shibbs/Light_node/Documentation/Hardware_configuration_notes.rtf

If you want to control an external LED Strip :

By default the LED strip must be powered from USB power. To change it so that the LED strip can be controlled from battery power you need to :
Cut the 5V trace that runs to the LED strip (show picture)
Solder the Vbatt line to the LED strip’s 5V pin (show picture)

If you do not intend to ever use Battery power but still want to use the LEDs on board:
Do not populate U10 and the surrounding electronics
Solder short JP11
May have trouble controlling the LEDs still, not sure really because of voltage issues on board

If you don’t want to use the accelerometer
Do not populate U20 and surrounding parts
