shibbs/Light_node/pcb_design/board info.rtf

gerber info :

cutout/dxf : OTL
Top copper : GTL
bottom copper GBL
top paste GTP
bottom silk GBO
top soldermask GTS
bottom soldermask GBS
drill info DRI
drill location txt
