shibbs/Light_node/Documentation/Purchase_list.rtf

validation issues that require clarification
IST 71047 71046 71045

1 x pack of 3-pin JST conectors - https://www.amazon.com/HKBAYI-50Pair-50sets-Connector-WS2812B/dp/B00NBSH4CA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.

9 x 5m LED Strips https://www.amazon.com/dp/B0722XX2RK/ref=sspa_dk_detail_0?th=1

1 x 1m high density LED Strip - https://www.amazon.com/gp/product/B01CDTEJR0/ref=ox_sc_act_title_2?smid=A35UAT07QG3EC6&psc=1

1 x Spirit hood - https://www.amazon.com/gp/product/B075VS5ZLP/ref=oh_aui_detailpage_o01_s00?ie=UTF8&psc=1

Send reminder/prep e-mail
get code working and sorted
make basic functions
