shibbs/Light_node/light_node_BOM.xls

Sheet: BOM_11_26
Digi-Key Part Number | Manufacturer | Manufacturer Part Number | Description | Customer Reference |  | Quantity 1 | Price | 7.4712 | Quantity 2 | Price | Quantity 3 | Price | Stock Status | Mfg Std Lead Time | Comments | RoHS Status | Lead Free Status | REACH Status
497-10613-1-ND | STMICROELECTRONICS (VA) | LIS3DHTR | ACCEL 2-16G I2C/SPI 16LGA | U20 | Accel | 35 | 1.37 | 1.37 | 0 | 0.00000 | 0 | 0.00000 | IN STOCK | 16 Weeks | Alternate Packaging Exists | RoHS Compliant | Lead free | Not Available
BAW56LT1GOSCT-ND | ON SEMICONDUCTOR (VA) | BAW56LT1G | DIODE ARRAY GP 70V 200MA SOT23-3 | U50 | Strip Diodes | 35 | 0.098 | 0.098 | 0 | 0.00000 | 0 | 0.00000 | IN STOCK | 12 Weeks | Alternate Packaging Exists | RoHS Compliant | Lead free | Unaffected Jul-2017
ATMEGA328P-MURCT-ND | MICROCHIP TECHNOLOGY (VA) | ATMEGA328P-MUR | IC MCU 8BIT 32KB FLASH 32VQFN | U30 | MCU | 35 | 2.0056 | 2.0056 | 0 | 0.00000 | 0 | 0.00000 | IN STOCK | 16 Weeks | Alternate Packaging Exists | RoHS Compliant | Lead free | Unaffected Jan-2017
MCP73831T-2ACI/OTCT-ND | MICROCHIP TECHNOLOGY (VA) | MCP73831T-2ACI/OT | IC CONTROLLR LI-ION 4.2V SOT23-5 | U10 | Batt- IC | 35 | 0.4936 | 0.4936 | 0 | 0.00000 | 0 | 0.00000 | IN STOCK | 6 Weeks | Alternate Packaging Exists | RoHS Compliant | Lead free | Unaffected Jan-2017
576-2980-1-ND | MICROCHIP TECHNOLOGY (VA) | MIC5225-3.3YM5-TR | IC REG LINEAR 3.3V 150MA SOT23-5 | U40 | MCU Reg | 35 | 0.336 | 0.336 | 0 | 0.00000 | 0 | 0.00000 | IN STOCK | 6 Weeks | Alternate Packaging Exists | RoHS Compliant | Lead free | Unaffected Jan-2017
455-1802-1-ND | JST SALES AMERICA INC (VA) | SM02B-SRSS-TB(LF)(SN) | CONN HEADER SH 2POS SIDE 1MM TIN | JP11 | Batt-Con | 35 | 0.415 | 0.415 | 0 | 0.00000 | 0 | 0.00000 | IN STOCK | 14 Weeks | Alternate Packaging Exists | RoHS Compliant | Lead free | Not Available
455-1626-ND | JST SALES AMERICA INC | S3B-EH(LF)(SN) | CONN HEADER EH SIDE 3POS 2.5MM | JP3 | Strip- Conn | 35 | 0.187 | 0.187 | 0 | 0.00000 | 0 | 0.00000 | IN STOCK | 14 Weeks |  | RoHS Compliant | Lead free | Not Available
3306P-104-ND | BOURNS INC | 3306P-1-104 | TRIMMER 100K OHM 0.2W PC PIN | R7 | POT | 35 | 0.36 | 0.36 | 0 | 0.00000 | 0 | 0.00000 | AVAIL 0/BAL 18 WKS ARO | 18 Weeks |  | RoHS Compliant | Lead free | Unaffected Jan-2017
609-4618-1-ND | AMPHENOL FCI (VA) | 10118194-0001LF | CONN USB MICRO B RECPT SMT R/A | USB_PORT | MCU USB Conn | 35 | 0.3744 | 0.3744 | 0 | 0.00000 | 0 | 0.00000 | IN STOCK | 12 Weeks | Alternate Packaging Exists | RoHS Compliant | Lead free | Not Available
401-1999-1-ND | C&K (VA) | JS102011SAQN | SWITCH SLIDE SPDT 300MA 6V | U$8 – SWITCH | Switch | 35 | 0.5016 | 0.5016 | 0 | 0.00000 | 0 | 0.00000 | IN STOCK | 10 Weeks | Alternate Packaging Exists | RoHS Compliant | Lead free | Unaffected Jan-2017
1253-1675-1-ND |  |  | 16Mhz Crystal | Y30 | MCU Xtal | 35 | 0.33 | 0.33
 | Neopixel |  |  |  | LEDs | 70 | 0.5 | 1
 | Lion Battery |  |  |  | BATtery | 35 |  | 0
 |  |  |  | Basic stuff |  |  |  | 4.046
 |  |  |  | Accel |  |  |  | 1.37
 |  |  |  | SWITCH |  |  |  | 0.5016
 |  |  |  | LEDs |  |  |  | 1
 |  |  |  | LED Strip |  |  |  | 0.285
 |  |  |  | Battery |  |  |  | 0.9086
 |  |  |  | Potentiometer |  |  |  | 0.36
Stencil | 19.66 |  |  |  |  |  |  | 8.4712
PCBs x 60
Solder Paste

Sheet: partlist
Partlist
Exported | from Light_node.sch at | 11/29/17 4:14 PM
EAGLE Ver | sion 7.5.0 Copyright (c | ) 1988-2015 CadSoft
Assembly | variant:
Part | Value | Device | Package Library Sheet
C10 | 10uF | CAP_CERAMIC0805-NOOUTLINE | 0805-NO microbuilder 1
C11 | 10uF | CAP_CERAMIC0805-NOOUTLINE | 0805-NO microbuilder 1
C20 | 10uF | CAP_CERAMIC0805-NOOUTLINE | 0805-NO microbuilder 1
C30 | 0.1uF | CAP_CERAMIC_0805MP | _0805MP microbuilder 1
C31 | 0.1uF | CAP_CERAMIC0805-NOOUTLINE | 0805-NO microbuilder 1
C40 | 10uF | CAP_CERAMIC0805-NOOUTLINE | 0805-NO microbuilder 1
C41 | 10uF | CAP_CERAMIC0805-NOOUTLINE | 0805-NO microbuilder 1
R1 | 68 (0603) | RESISTOR_0603_NOOUT | 0603-NO microbuilder 1
R10 | 470 | RESISTOR0805_NOOUTLINE | 0805-NO microbuilder 1
R11 | 10K | RESISTOR0805_NOOUTLINE | 0805-NO microbuilder 1
R2 | 68 (0603) | RESISTOR_0603_NOOUT | 0603-NO microbuilder 1
R3 | 1.5K (0603) | RESISTOR_0603_NOOUT | 0603-NO microbuilder 1
R20 | 10K | RESISTOR0805_NOOUTLINE | 0805-NO microbuilder 1
R21 | 10K | RESISTOR0805_NOOUTLINE | 0805-NO microbuilder 1
R30 | 10K (0603) | RESISTOR0805_NOOUTLINE | 0805-NO microbuilder 1
R50 | 10K | RESISTOR_0603_NOOUT | 0603-NO microbuilder 1
R40 | 470 (0603) | RESISTOR_0603_NOOUT | 0603-NO microbuilder 1
R5 | 470 (0603) | RESISTOR_0603_NOOUT | 0603-NO microbuilder 1
R9 | 470 (0603) | RESISTOR_0603_NOOUT | 0603-NO microbuilder 1
RGB1 | WS2812B5050 | WS2812B5050 | WS2812B microbuilder 1
RGB2 | WS2812B5050 | WS2812B5050 | WS2812B microbuilder 1
U$8 | SPDT_NO_GNDSMT | SPDT_NO_GNDSMT | JS102011SAQN 0_Shibbs1 1
U10 | MCP73831T-2ACI/OT | MCP73831/2 | SOT23-5 microbuilder 1
U20 | LIS3DHTR | ACCEL_LIS3DHTR | LGA16_3X3MM microbuilder 1
U30 | ATmega328P | MEGA8-MI | MLF32-TH microbuilder 1
U40 | MIC5225-3.3v | LP298XS | SOT23-5L adafruit 1
U50 | COMMON_ANODE_DIODE | COMMON_ANODE_DIODE | SOT23 0_AlpineLabs 1
Y30 | 12MHz | RESONATORSMD | RESONATOR-SMD SparkFun 1
B1 | GREEN | LED0805_NOOUTLINE | CHIPLED_0805_NOOUTLINE microbuilder 1 | All LEDs are same in BOM
PWR_LED | green | LED0805_NOOUTLINE | CHIPLED_0805_NOOUTLINE microbuilder 1 | All LEDs are same in BOM
CH_LED | GREEN | LED0805_NOOUTLINE | CHIPLED_0805_NOOUTLINE microbuilder 1 | All LEDs are same in BOM
D40 | SCHOTTKY | DIODE_SOD-123FL | SOD-123FL adafruit 1
JP1 | USB_MICROB_PLUG_CUSTOM | USB_MICROB_PLUG_CUSTOM | USB-MICROB 0_AlpineLabs 1
JP3 | JSTPH | JST_2PIN | JSTPH2 microbuilder 1
JP5 | M03 | M03 | M03_25MM 0_Shibbs1 1
POT |  | POT | 3306P_POT 0_Shibbs1 1
