shibbs/Light_node/Placement_Guideline2 copy.jpg

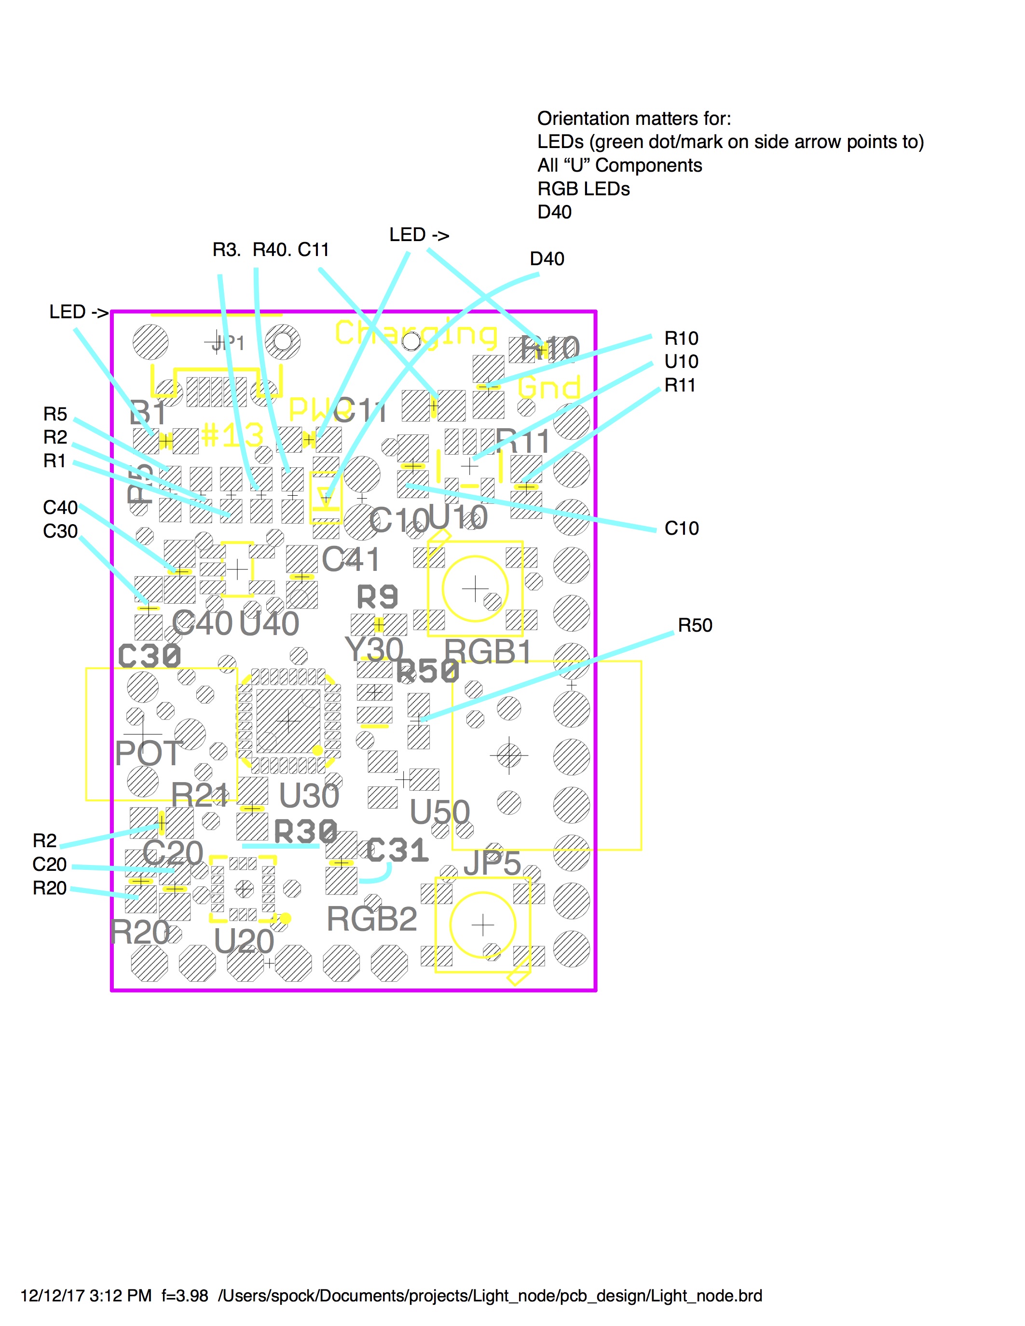
Placement_Guideline2 copy.jpg
