shibbs/Light_node/Placement_Guideline2.pdf

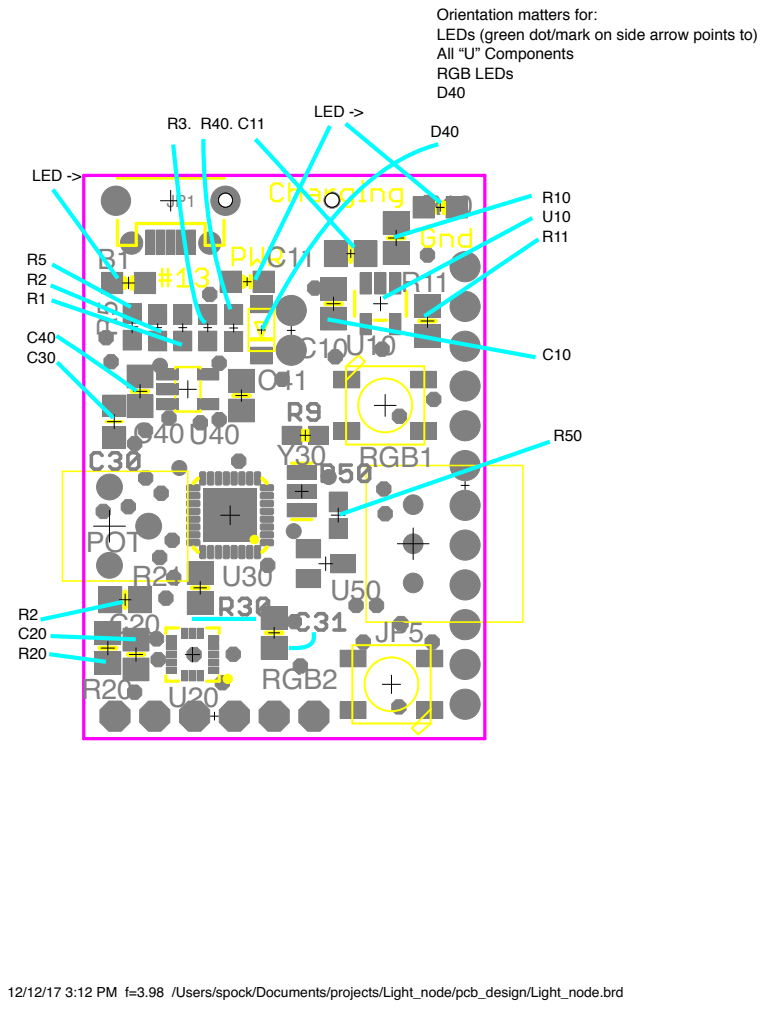
[picture p2: page 1]

Orientation matters for:
LEDs (green dot/mark on side arrow points to)
All “U” Components
RGB LEDs

12/12/17 3:12 PM f=3.98 /Users/spock/Documents/projects/Light_node/pcb_design/Light_node.brd
