shibbs/Light_node/pcb_design/Light_node.brd

## EAGLE design pcb_design/Light_node.brd (2017-12-17)

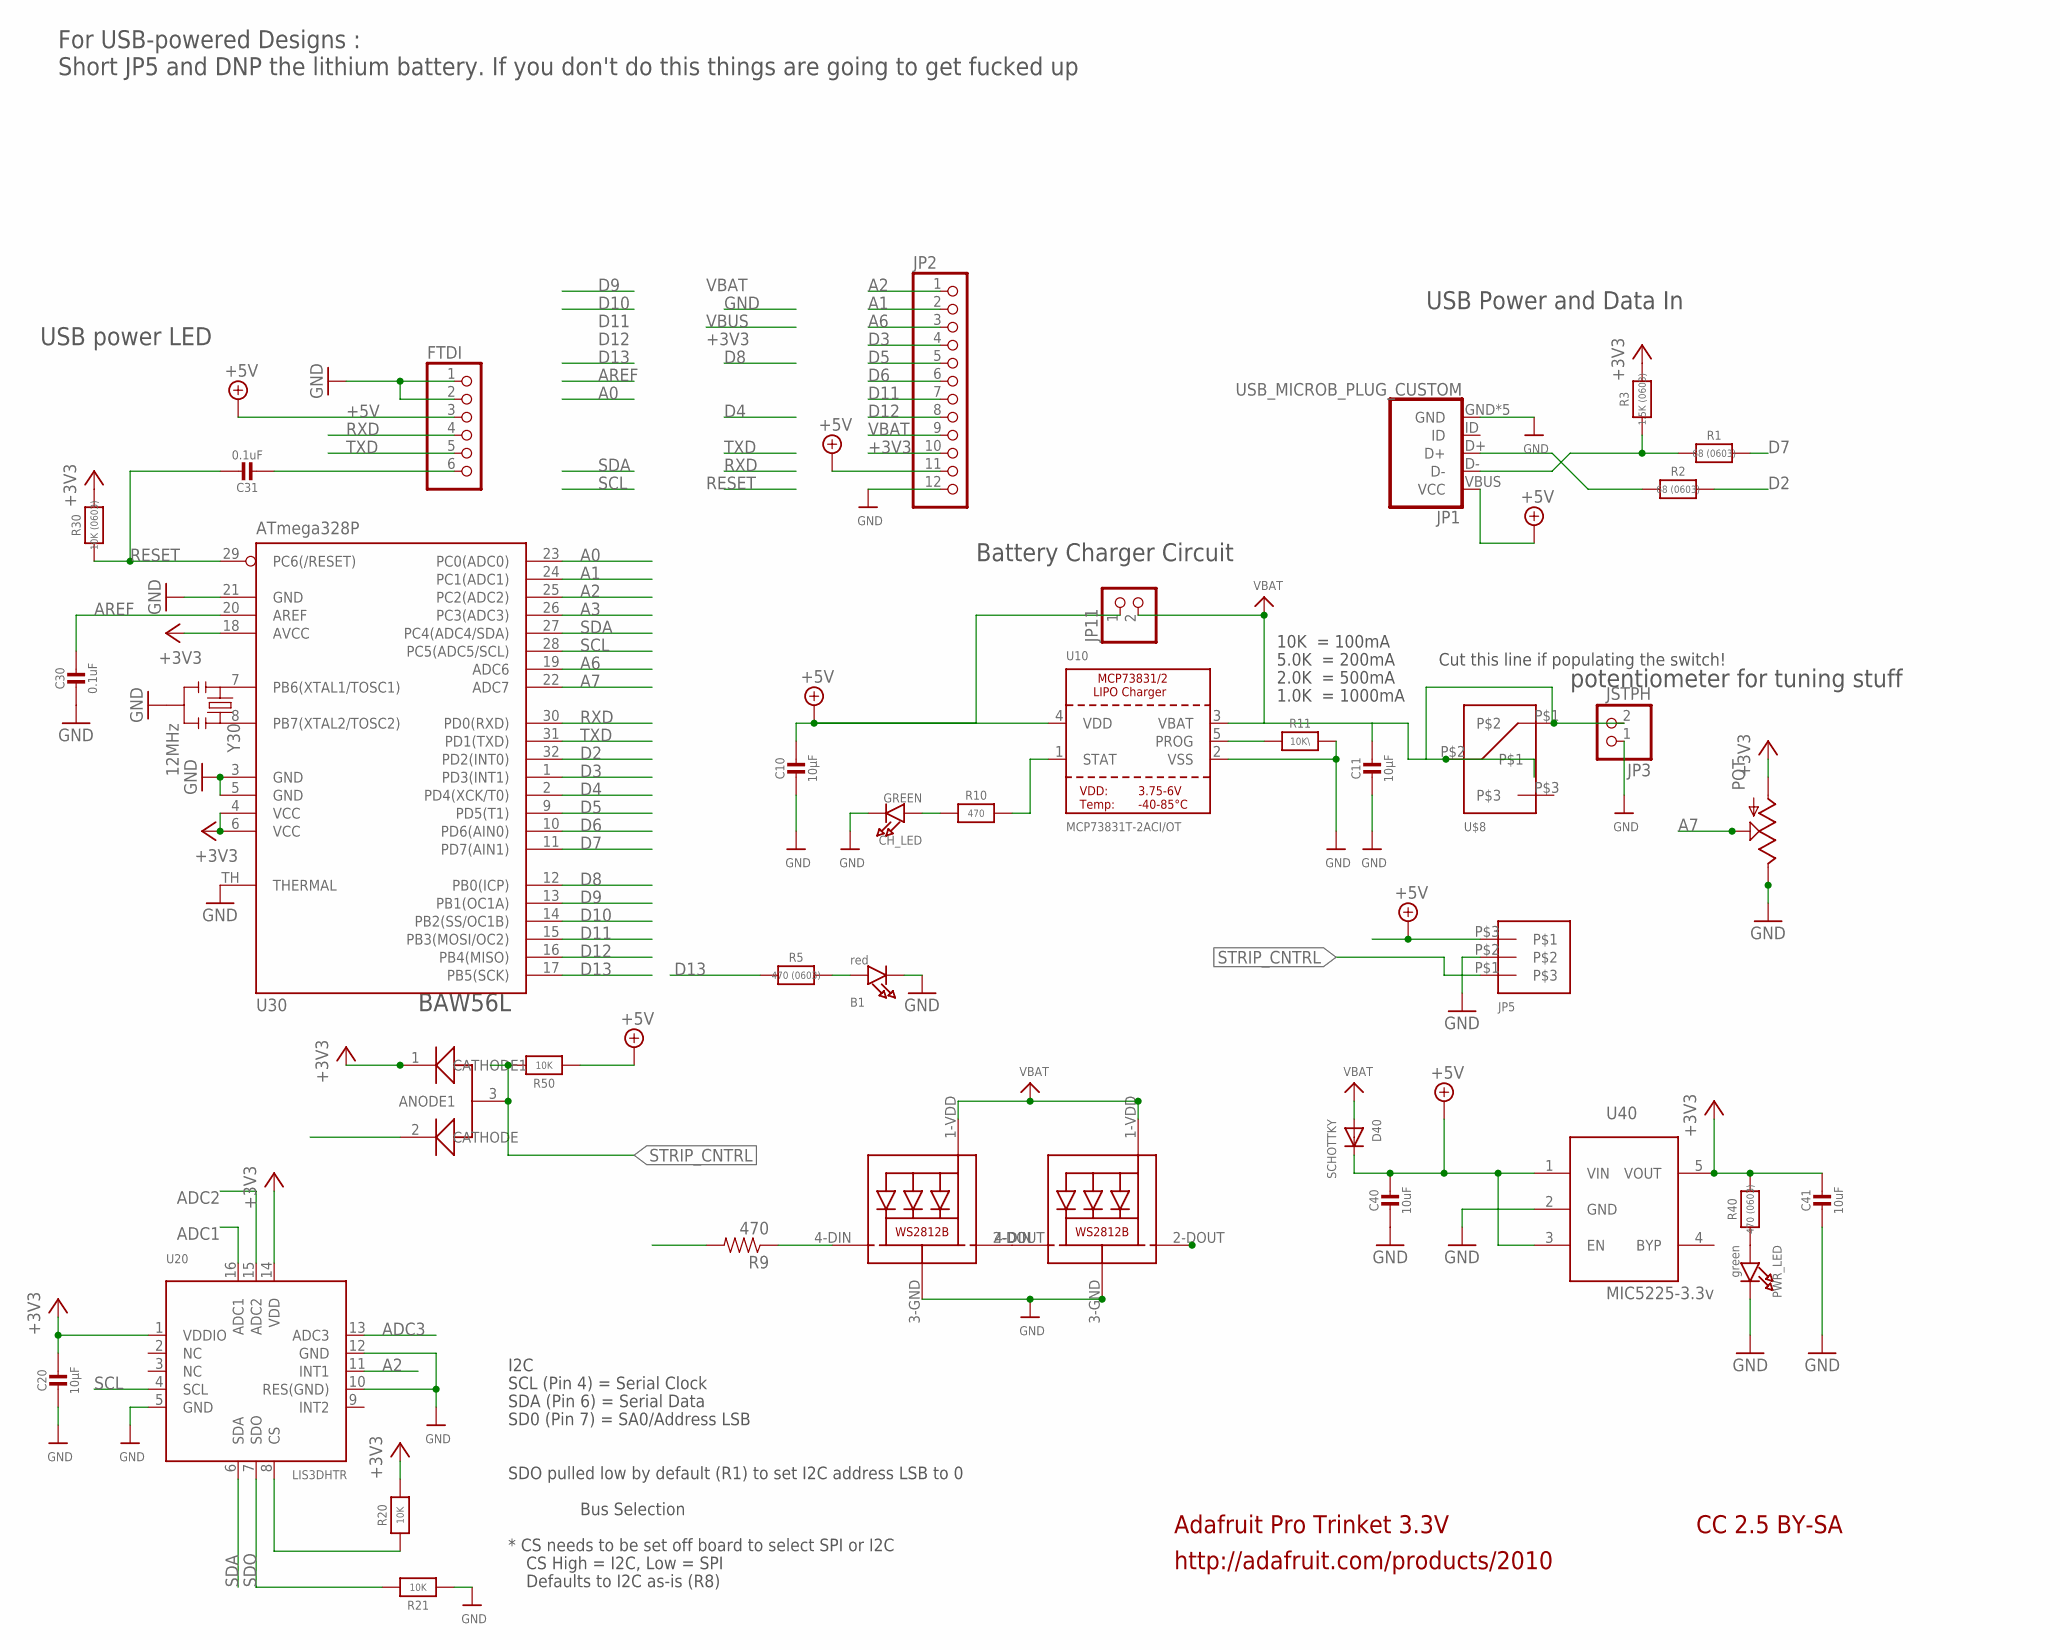
[picture p3: schematic Light_node.sch]

Parts:
B1: red; CHIPLED_0805_NOOUTLINE
C10, C11, C20: 10µF; 0805-NO
C30: 0.1uF; _0805MP
C31: 0.1uF; 0805-NO
C40, C41: 10uF; 0805-NO
CH_LED: GREEN; CHIPLED_0805_NOOUTLINE
D40: SCHOTTKY; SOD-123FL
FTDI: PINHD-1X6CB; 1X06-CLEANBIG
JP1: USB_MICROB_PLUG_CUSTOM; USB-MICROB
JP2: PINHD-1X12-CB; 1X12-CB
JP3: JSTPH; JSTPH2
JP5: M03; M03_25MM
JP11: HEADER-1X2ROUND; 1X02_ROUND
POT: POT; 3306P_POT
PWR_LED: green; CHIPLED_0805_NOOUTLINE
R1, R2: 68 (0603); 0603-NO
R3: 1.5K (0603); 0603-NO
R5, R40: 470 (0603); 0603-NO
R9: 470; 0603-RES
R10: 470; 0805-NO
R11: 10K\; 0805-NO
R20, R21: 10K; 0805-NO
R30: 10K (0603); 0805-NO
R50: 10K; 0603-NO
RGB1, RGB2: WS2812B5050; WS2812B
U10: MCP73831T-2ACI/OT; SOT23-5
U20: LIS3DHTR; LGA16_3X3MM
U30: ATmega328P; MLF32-TH
U40: MIC5225-3.3v; SOT23-5L
U50: COMMON_ANODE_DIODE; SOT23
U$8: SPDT_NO_GNDSMT; JS102011SAQN
Y30: 12MHz; RESONATOR-SMD

Connections:
+3V3: C20.1, C41.1, JP2.10, POT.P$1 (A), R3.2, R20.2, R30.2, R40.2, U20.1 (VDDIO), U20.14 (VDD), U30.4 (VCC), U30.6 (VCC), U30.18 (AVCC), U40.5 (VOUT), U50.1 (CATHODE1)
+5V: C10.1, C40.1, D40.C, FTDI.3, JP1.VBUS (VCC), JP2.11, JP5.P$3, JP11.1, R50.1, U10.4 (VDD), U40.1 (VIN), U40.3 (EN)
A0: U30.23 (PC0(ADC0))
A1: JP2.2, U30.24 (PC1(ADC1))
A2: JP2.1, U20.11 (INT1), U30.25 (PC2(ADC2))
A3: U30.26 (PC3(ADC3))
A6: JP2.3, U30.19 (ADC6)
A7: POT.P$3 (S), U30.22 (ADC7)
ADC1: U20.16 (ADC1)
ADC2: U20.15 (ADC2)
ADC3: U20.13 (ADC3)
AREF: C30.1, U30.20 (AREF)
CS: R20.1, U20.8 (CS)
D2: R2.2, U30.32 (PD2(INT0))
D3: JP2.4, U30.1 (PD3(INT1))
D4: U30.2 (PD4(XCK/T0)), U50.2 (CATHODE)
D5: JP2.5, U30.9 (PD5(T1))
D6: JP2.6, U30.10 (PD6(AIN0))
D7: R1.2, U30.11 (PD7(AIN1))
D8: U30.12 (PB0(ICP))
D9: U30.13 (PB1(OC1A))
D10: R9.2, U30.14 (PB2(SS/OC1B))
D11: JP2.7, U30.15 (PB3(MOSI/OC2))
D12: JP2.8, U30.16 (PB4(MISO))
D13: R5.2, U30.17 (PB5(SCK))
D+: JP1.D+, R2.1
D-: JP1.D-, R1.1, R3.1
DTR/RTS: C31.2, FTDI.6
GND: B1.C, C10.2, C11.2, C20.2, C30.2, C40.2, C41.2, CH_LED.C, FTDI.1, FTDI.2, JP1.GND, JP1.P$1 (GND), JP1.P$2 (GND), JP1.P$3 (GND), JP1.P$4 (GND), JP2.12, JP3.1, JP5.P$2, POT.P$2 (E), PWR_LED.C, R11.2, R21.1, RGB1.3-GND (GND), RGB2.3-GND (GND), U10.2 (VSS), U20.5 (GND), U20.10 (RES(GND)), U20.12 (GND), U30.3 (GND), U30.5 (GND), U30.21 (GND), U30.TH (THERMAL), U40.2 (GND), Y30.2
LED_CNTRL: R9.1, RGB1.4-DIN (DI)
unnamed: B1.A, R5.1
unnamed: U30.8 (PB7(XTAL2/TOSC2)), Y30.3
unnamed: U30.7 (PB6(XTAL1/TOSC1)), Y30.1
unnamed: RGB1.2-DOUT (DO), RGB2.4-DIN (DI)
unnamed: R10.2, U10.1 (STAT)
unnamed: PWR_LED.A, R40.1
unnamed: R11.1, U10.5 (PROG)
unnamed: CH_LED.A, R10.1
RESET: C31.1, R30.1, U30.29 (PC6(/RESET))
RXD: FTDI.4, U30.30 (PD0(RXD))
SCL: U20.4 (SCL), U30.28 (PC5(ADC5/SCL))
SDA: U20.6 (SDA), U30.27 (PC4(ADC4/SDA))
SDO: R21.2, U20.7 (SDO)
STRIP_CNTRL: JP5.P$1, R50.2, U50.3 (ANODE1)
TXD: FTDI.5, U30.31 (PD1(TXD))
VBAT: C11.1, D40.A, JP2.9, JP3.2, JP11.2, RGB1.1-VDD (VDD), RGB2.1-VDD (VDD), U10.3 (VBAT), U$8.P$1, U$8.P$2

Notes on the sheet:
Adafruit Pro Trinket 3.3V
http://adafruit.com/products/2010
CC 2.5 BY-SA
10K = 100mA
5.0K = 200mA
2.0K = 500mA
1.0K = 1000mA
Battery Charger Circuit
USB power LED
USB Power and Data In
potentiometer for tuning stuff
I2C
SCL (Pin 4) = Serial Clock
SDA (Pin 6) = Serial Data
SD0 (Pin 7) = SA0/Address LSB
* CS needs to be set off board to select SPI or I2C
CS High = I2C, Low = SPI
Defaults to I2C as-is (R8)
SDO pulled low by default (R1) to set I2C address LSB to 0
Bus Selection
For USB-powered Designs : Short JP5 and DNP the lithium battery. If you don't do this things are going to get fucked up
BAW56L
Cut this line if populating the switch!

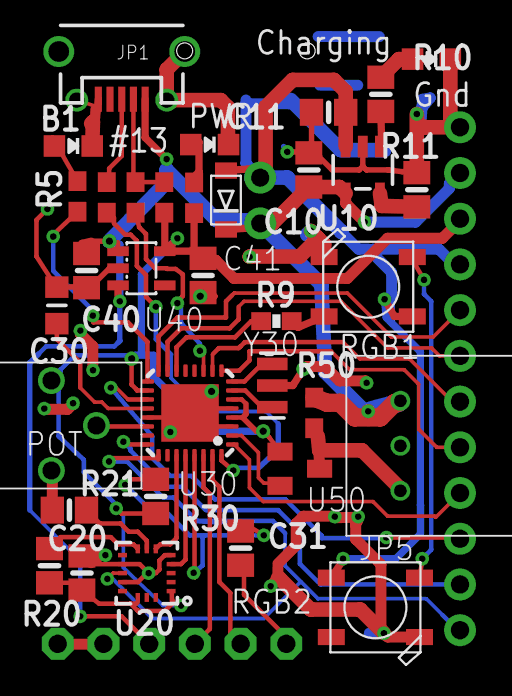
[picture p4: board Light_node.brd from above]

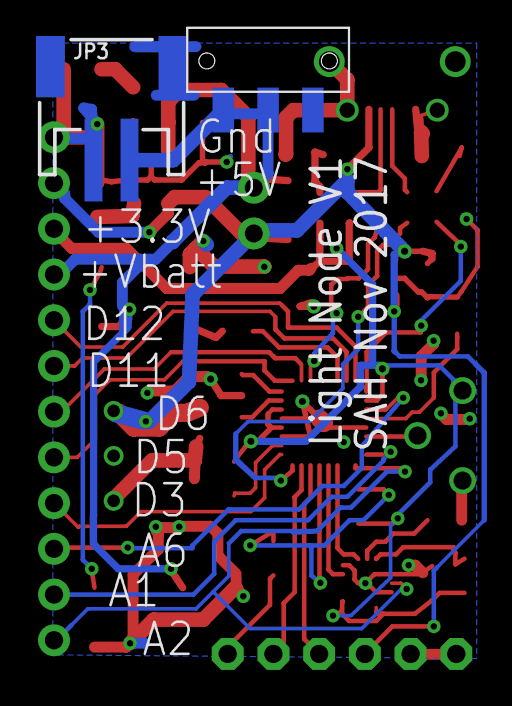
[picture p5: board Light_node.brd from below]

Board: 2 copper layers, 39 parts (2 on the bottom side), 39 nets.
