shibbs/Light_node/pcb_design/reference pcb_cad/NeoPixel-Sticks-master/Adafruit NeoPixel 8 Stick v2.brd

## EAGLE design pcb_design/reference pcb_cad/NeoPixel-Sticks-master/Adafruit NeoPixel 8 Stick v2.brd (2017-11-10)

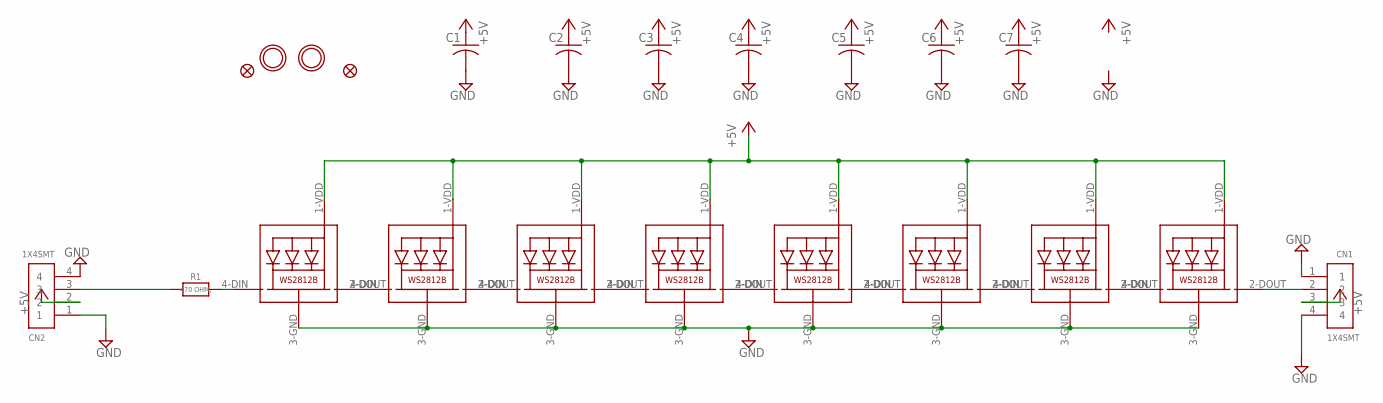
[picture p6: schematic Adafruit NeoPixel 8 Stick v2.sch]

Parts:
C1, C2, C3, C4, C5, C6, C7: C-USC0805K; C0805K
CN1, CN2: 1X4SMT; 1X4-SMT
FID1, FID3: FIDUCIAL""; FIDUCIAL_1MM
LED1, LED2, LED3, LED4, LED5, LED6, LED7, LED8: WS2812B5050; WS2812B
R1: 470 OHM,; _0805MP
U$2, U$3: MOUNTINGHOLE2.0; MOUNTINGHOLE_2.0_PLATED

Connections:
+5V: C1.1, C2.1, C3.1, C4.1, C5.1, C6.1, C7.1, CN1.3, CN2.2, LED1.1-VDD (VDD), LED2.1-VDD (VDD), LED3.1-VDD (VDD), LED4.1-VDD (VDD), LED5.1-VDD (VDD), LED6.1-VDD (VDD), LED7.1-VDD (VDD), LED8.1-VDD (VDD)
GND: C1.2, C2.2, C3.2, C4.2, C5.2, C6.2, C7.2, CN1.1, CN1.4, CN2.1, CN2.4, LED1.3-GND (GND), LED2.3-GND (GND), LED3.3-GND (GND), LED4.3-GND (GND), LED5.3-GND (GND), LED6.3-GND (GND), LED7.3-GND (GND), LED8.3-GND (GND)
unnamed: LED1.2-DOUT (DO), LED2.4-DIN (DI)
unnamed: LED2.2-DOUT (DO), LED3.4-DIN (DI)
unnamed: LED3.2-DOUT (DO), LED4.4-DIN (DI)
unnamed: LED4.2-DOUT (DO), LED5.4-DIN (DI)
unnamed: LED5.2-DOUT (DO), LED6.4-DIN (DI)
unnamed: LED6.2-DOUT (DO), LED7.4-DIN (DI)
unnamed: LED7.2-DOUT (DO), LED8.4-DIN (DI)
unnamed: CN2.3, R1.1
unnamed: CN1.2, LED8.2-DOUT (DO)
unnamed: LED1.4-DIN (DI), R1.2

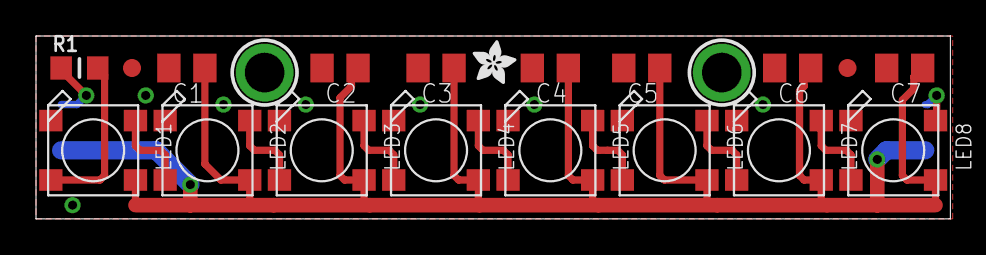
[picture p7: board Adafruit NeoPixel 8 Stick v2.brd from above]

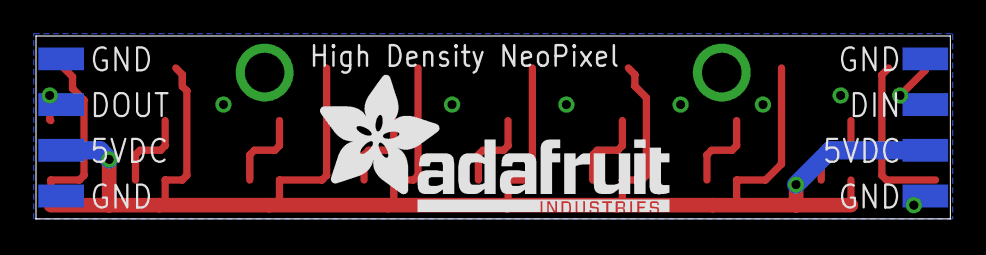
[picture p8: board Adafruit NeoPixel 8 Stick v2.brd from below]

Board: 2 copper layers, 50.8 x 10.2 mm, 24 parts (3 on the bottom side), 12 nets.

Other parts of the board:
U$1: ADAFRUIT_TEXT_20MM
U$4: ADAFRUIT_2.5MM
