shibbs/Light_node/pcb_design/reference pcb_cad/NeoPixel-Sticks-master/Adafruit NeoPixel 8 Stick.brd

## EAGLE design pcb_design/reference pcb_cad/NeoPixel-Sticks-master/Adafruit NeoPixel 8 Stick.brd (2017-11-10)

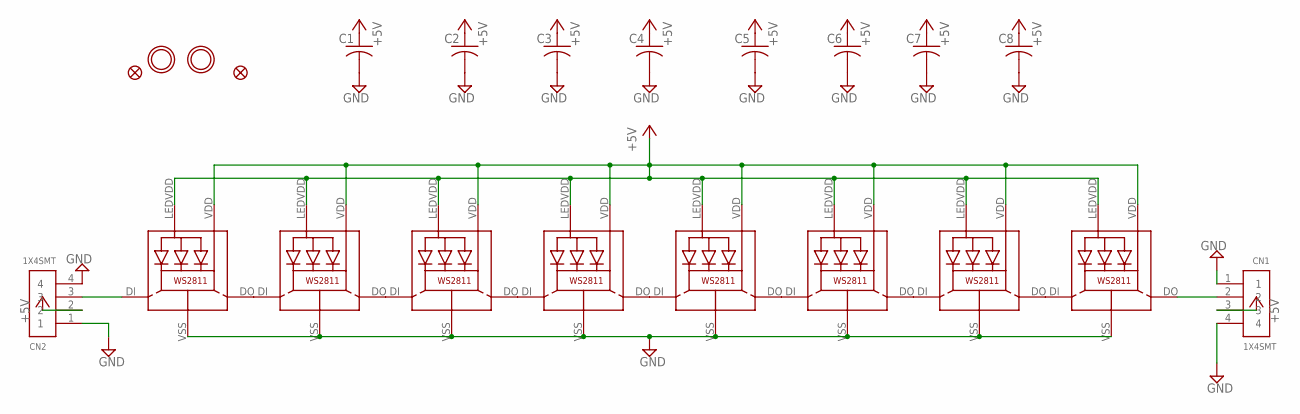
[picture p9: schematic Adafruit NeoPixel 8 Stick.sch]

Parts:
C1, C2, C3, C4, C5, C6, C7, C8: C-USC0805K; C0805K
CN1, CN2: 1X4SMT; 1X4-SMT
FID1, FID3: FIDUCIAL""; FIDUCIAL_1MM
LED1, LED2, LED3, LED4, LED5, LED6, LED7, LED8: WS28115050
U$2, U$3: MOUNTINGHOLE2.0; MOUNTINGHOLE_2.0_PLATED

Connections:
+5V: C1.1, C2.1, C3.1, C4.1, C5.1, C6.1, C7.1, C8.1, CN1.3, CN2.2, LED1.LEDVDD, LED1.VDD, LED2.LEDVDD, LED2.VDD, LED3.LEDVDD, LED3.VDD, LED4.LEDVDD, LED4.VDD, LED5.LEDVDD, LED5.VDD, LED6.LEDVDD, LED6.VDD, LED7.LEDVDD, LED7.VDD, LED8.LEDVDD, LED8.VDD
GND: C1.2, C2.2, C3.2, C4.2, C5.2, C6.2, C7.2, C8.2, CN1.1, CN1.4, CN2.1, CN2.4, LED1.VSS (GND), LED2.VSS (GND), LED3.VSS (GND), LED4.VSS (GND), LED5.VSS (GND), LED6.VSS (GND), LED7.VSS (GND), LED8.VSS (GND)
unnamed: LED1.DO, LED2.DI
unnamed: LED2.DO, LED3.DI
unnamed: LED3.DO, LED4.DI
unnamed: LED4.DO, LED5.DI
unnamed: LED5.DO, LED6.DI
unnamed: LED6.DO, LED7.DI
unnamed: LED7.DO, LED8.DI
unnamed: CN2.3, LED1.DI
unnamed: CN1.2, LED8.DO

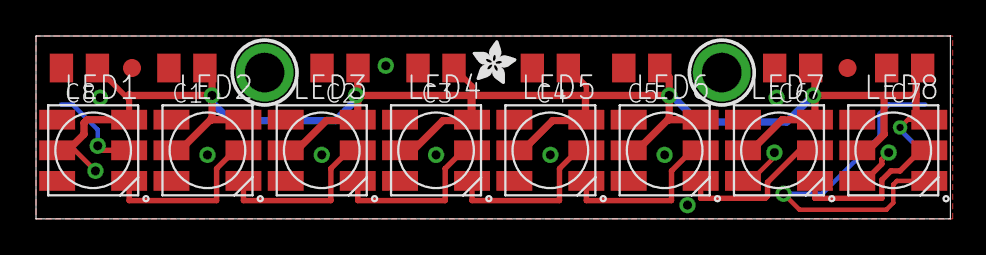
[picture p10: board Adafruit NeoPixel 8 Stick.brd from above]

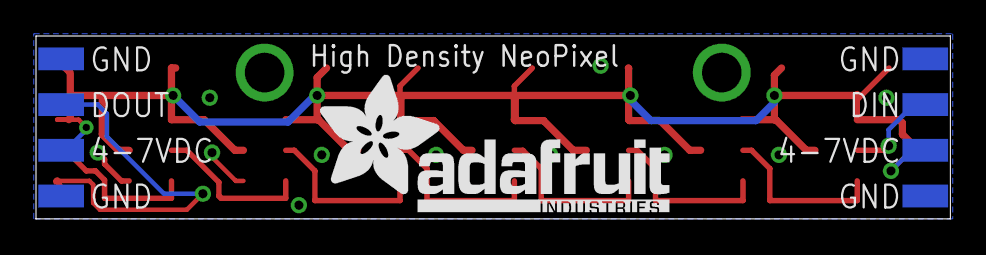
[picture p11: board Adafruit NeoPixel 8 Stick.brd from below]

Board: 2 copper layers, 50.8 x 10.2 mm, 24 parts (3 on the bottom side), 11 nets.

Other parts of the board:
U$1: ADAFRUIT_TEXT_20MM
U$4: ADAFRUIT_2.5MM
