shibbs/Light_node/pcb_design/reference pcb_cad/Adafruit-MicroLipo-PCB-master/Adafruit MicroLipo.brd

## EAGLE design pcb_design/reference pcb_cad/Adafruit-MicroLipo-PCB-master/Adafruit MicroLipo.brd (2017-11-10)

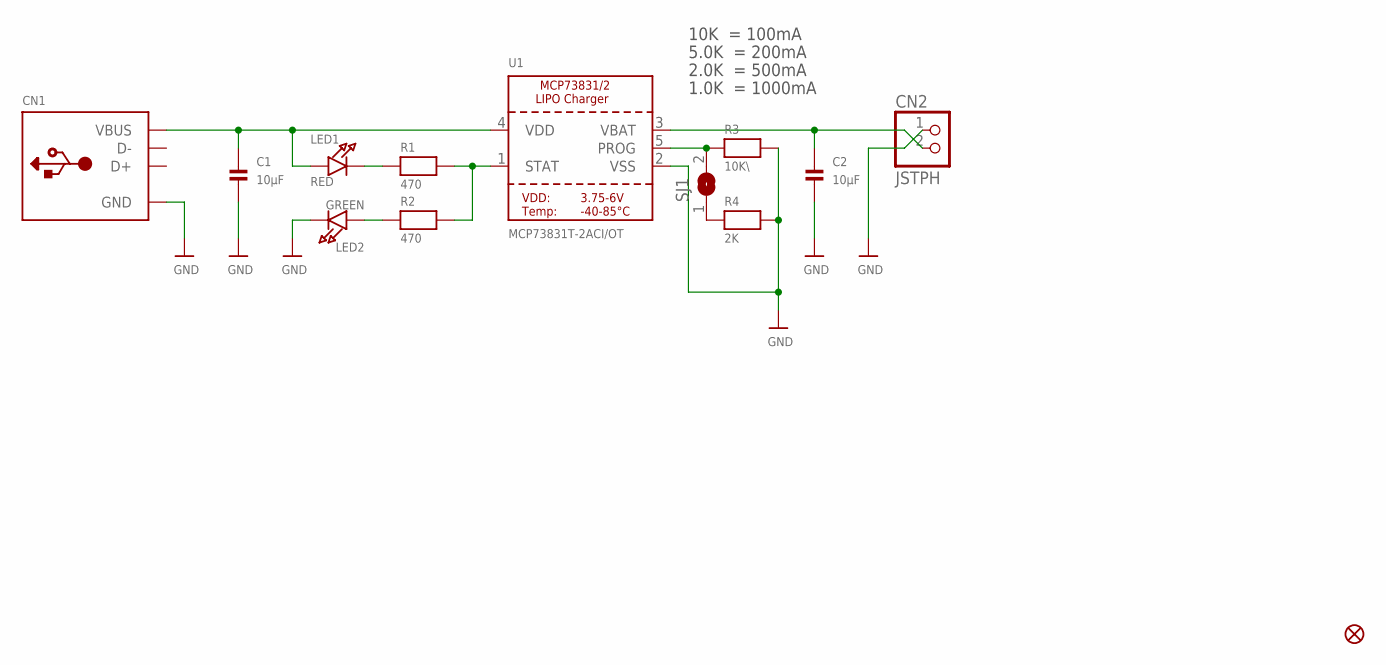
[picture p14: schematic Adafruit MicroLipo.sch]

Parts:
C1, C2: 10µF; 0805
CN1: USB_TYPEAPCB; USBA_PCB
CN2: JSTPH; JSTPH2
FID1: FIDUCIAL""; FIDUCIAL_1MM
LED1: RED; CHIPLED_0805
LED2: GREEN; CHIPLED_0805
R1, R2: 470; 0805
R3: 10K\; 0805
R4: 2K; 0805
SJ1: SOLDERJUMPER; SOLDERJUMPER_ARROW_NOPASTE
U1: MCP73831T-2ACI/OT; SOT23-5

Connections:
GND: C1.2, C2.2, CN1.GND, CN2.1, LED2.C, R3.2, R4.2, U1.2 (VSS)
unnamed: LED1.C, R1.1
unnamed: R1.2, R2.2, U1.1 (STAT)
unnamed: R4.1, SJ1.1
unnamed: R3.1, SJ1.2, U1.5 (PROG)
unnamed: LED2.A, R2.1
VBAT: C2.1, CN2.2, U1.3 (VBAT)
VDD: C1.1, CN1.VCC (VBUS), LED1.A, U1.4 (VDD)

Notes on the sheet:
10K = 100mA
5.0K = 200mA
2.0K = 500mA
1.0K = 1000mA

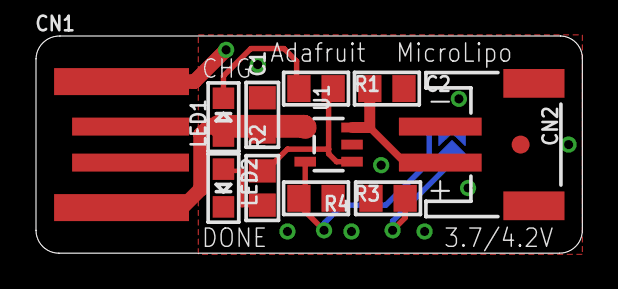
[picture p15: board Adafruit MicroLipo.brd from above]

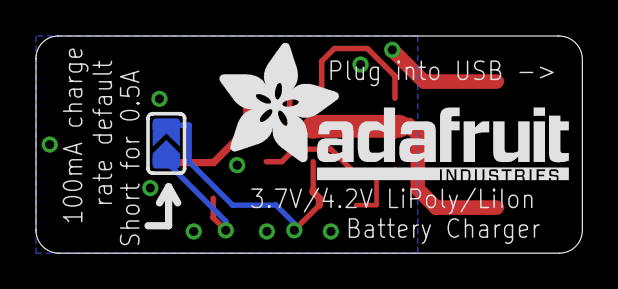
[picture p16: board Adafruit MicroLipo.brd from below]

Board: 2 copper layers, 30.4 x 12.1 mm, 14 parts (2 on the bottom side), 8 nets.

Other parts of the board:
U$8: ADAFRUIT_TEXT_20MM
