shibbs/Light_node/pcb_design/reference pcb_cad/Adafruit-MicroLipo-PCB-master/Adafruit protrinket backpack.brd

## EAGLE design pcb_design/reference pcb_cad/Adafruit-MicroLipo-PCB-master/Adafruit protrinket backpack.brd (2017-11-10)

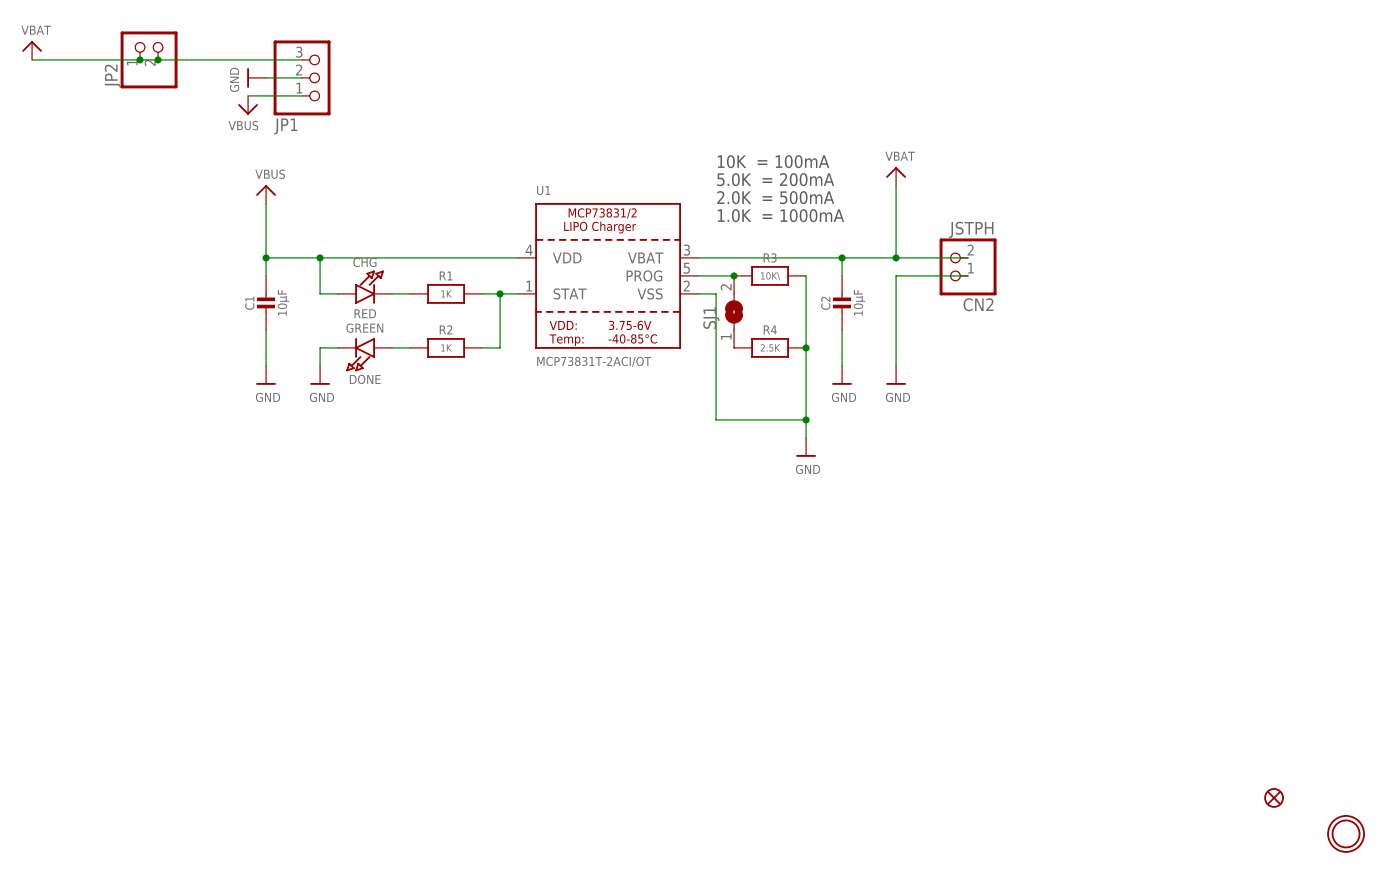
[picture p17: schematic Adafruit protrinket backpack.sch]

Parts:
C1, C2: 10µF; 0805-NO
CHG: RED; CHIPLED_0805_NOOUTLINE
CN2: JSTPH; JSTPH2
DONE: GREEN; CHIPLED_0805_NOOUTLINE
FID1: FIDUCIAL""; FIDUCIAL_1MM
JP1: HEADER-1X376MIL; 1X03_ROUND_76
JP2: HEADER-1X2ROUND; 1X02_ROUND
R1, R2: 1K; 0805-NO
R3: 10K\; _0805MP
R4: 2.5K; 0805-NO
SJ1: SOLDERJUMPER; SOLDERJUMPER_ARROW_NOPASTE
U1: MCP73831T-2ACI/OT; SOT23-5
U$10: MOUNTINGHOLE2.5; MOUNTINGHOLE_2.5_PLATED

Connections:
GND: C1.2, C2.2, CN2.1, DONE.C, JP1.2, R3.2, R4.2, U1.2 (VSS)
unnamed: CHG.C, R1.1
unnamed: R1.2, R2.2, U1.1 (STAT)
unnamed: R4.1, SJ1.1
unnamed: R3.1, SJ1.2, U1.5 (PROG)
unnamed: DONE.A, R2.1
VBAT: C2.1, CN2.2, JP1.3, JP2.1, JP2.2, U1.3 (VBAT)
VBUS: C1.1, CHG.A, JP1.1, U1.4 (VDD)

Notes on the sheet:
10K = 100mA
5.0K = 200mA
2.0K = 500mA
1.0K = 1000mA

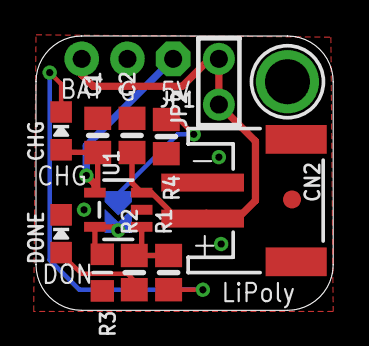
[picture p18: board Adafruit protrinket backpack.brd from above]

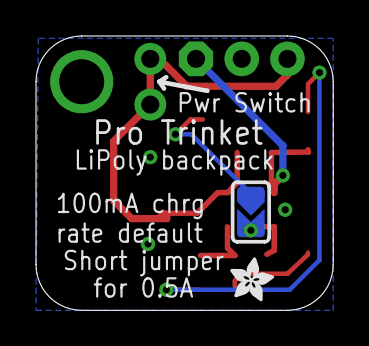
[picture p19: board Adafruit protrinket backpack.brd from below]

Board: 2 copper layers, 16.5 x 15.2 mm, 16 parts (2 on the bottom side), 8 nets.

Other parts of the board:
U$9: ADAFRUIT_2.5MM
