shibbs/Light_node/pcb_design/reference pcb_cad/Adafruit-Pro-Trinket-PCBs-master/Adafruit Pro Trinket 5v0.brd

## EAGLE design pcb_design/reference pcb_cad/Adafruit-Pro-Trinket-PCBs-master/Adafruit Pro Trinket 5v0.brd (2017-11-07)

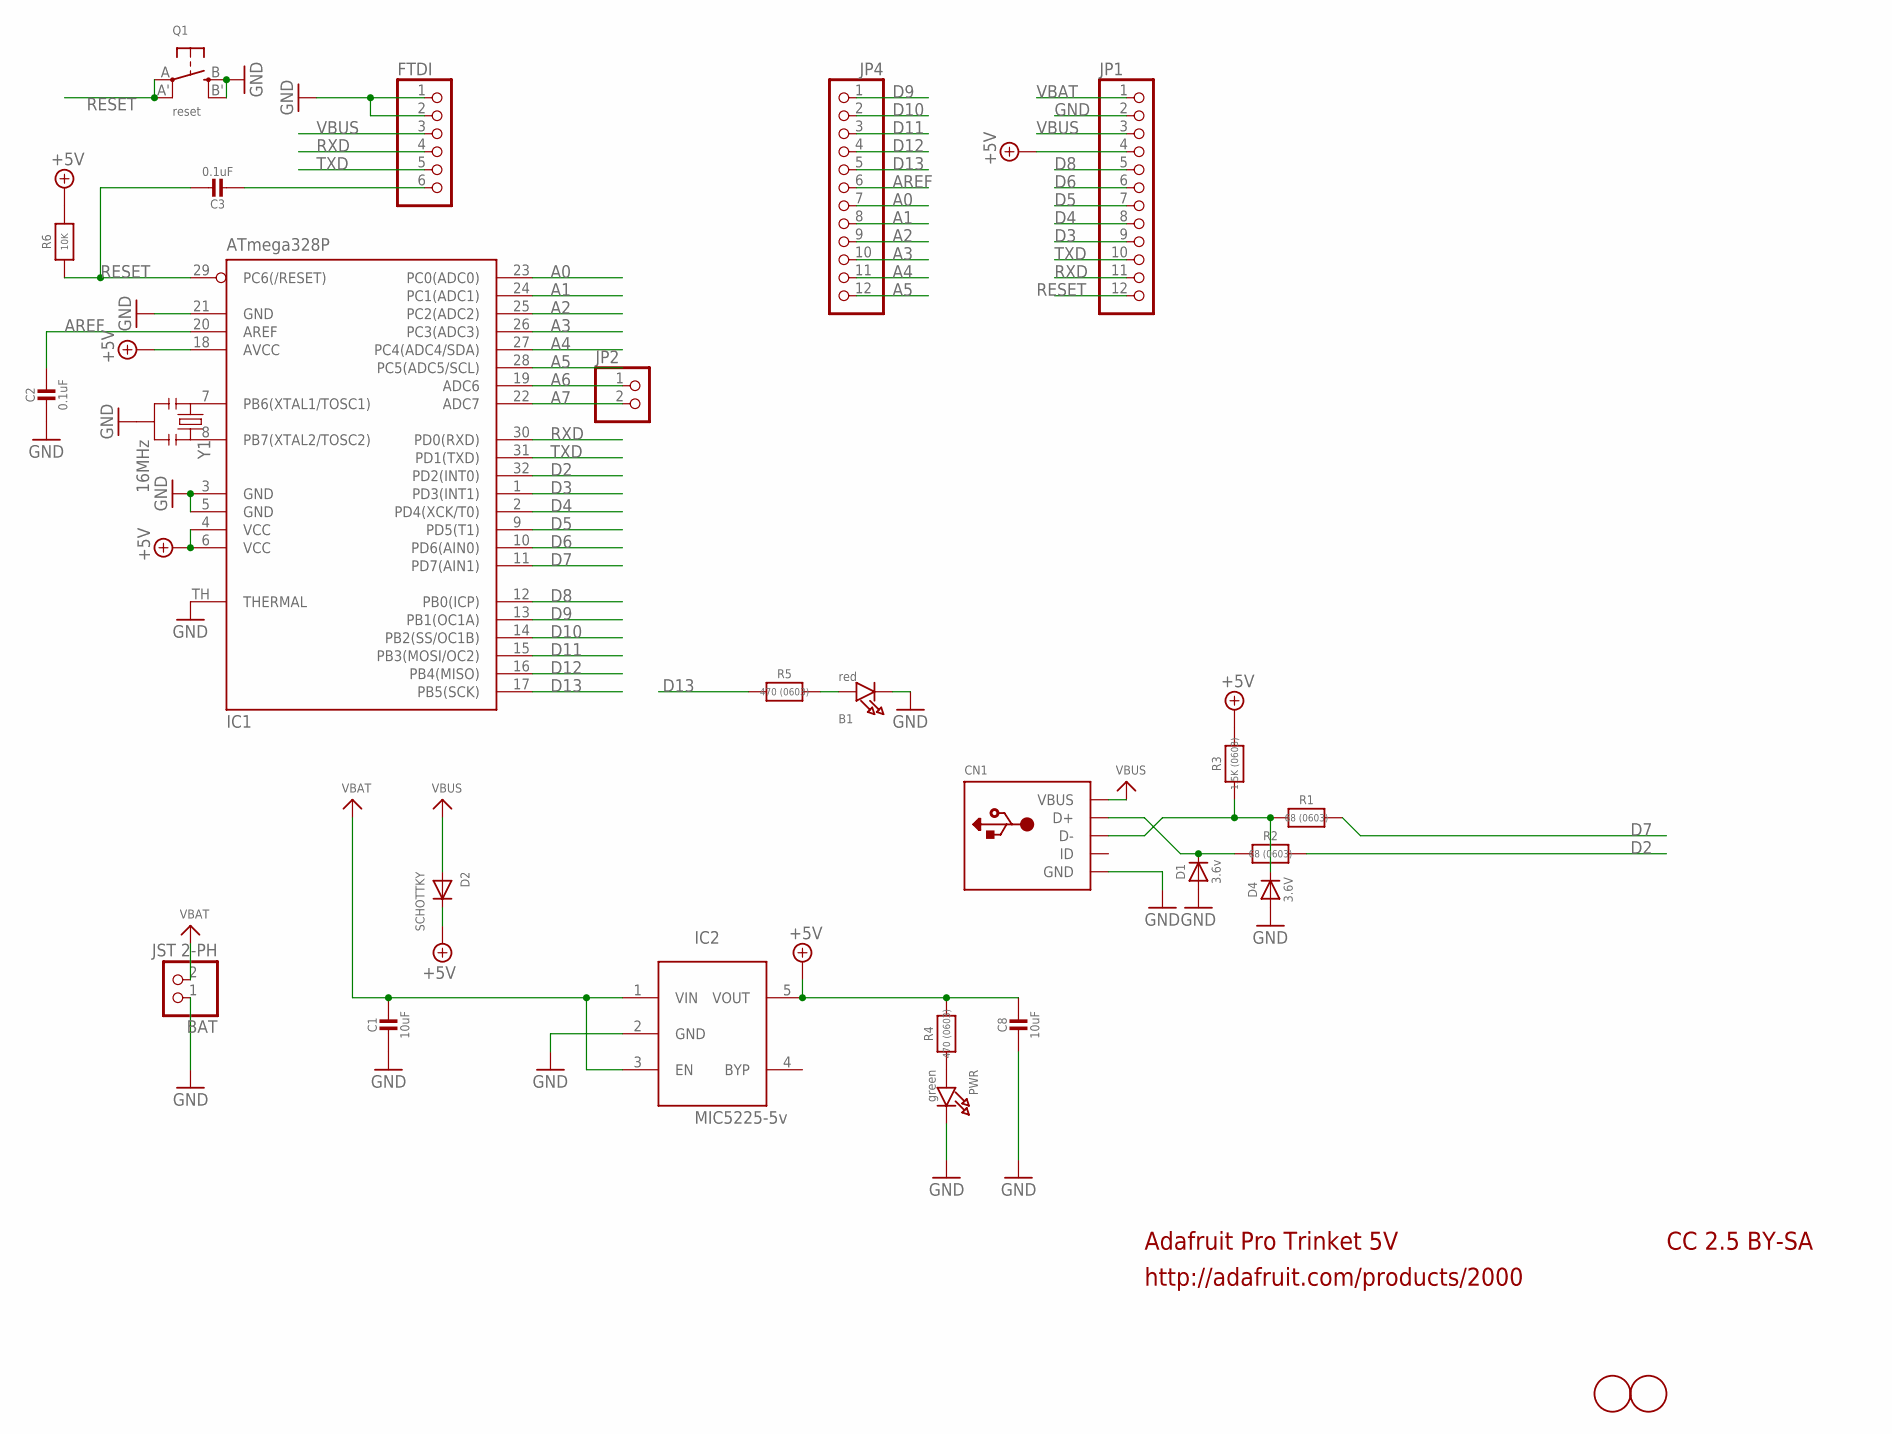
[picture p20: schematic Adafruit Pro Trinket 5v0.sch]

Parts:
B1: red; CHIPLED_0805_NOOUTLINE
BAT: JST 2-PH; JSTPH2
C1, C8: 10uF; 0805-NO
C2: 0.1uF; _0805MP
C3: 0.1uF; 0805-NO
CN1: USBMICRO_20329; 4UCONN_20329
D1: 3.6v; SOD-323
D2: SCHOTTKY; SOD-123FL
D4: 3.6V; SOD-323
FTDI: PINHD-1X6CB; 1X06-CLEANBIG
IC1: ATmega328P; MLF32-TH
IC2: MIC5225-5v; SOT23-5L
JP1, JP4: PINHD-1X12-CB; 1X12-CB
JP2: HEADER-1X2ROUND; 1X02_ROUND
PWR: green; CHIPLED_0805_NOOUTLINE
Q1: reset; BTN_KMR2_4.6X2.8
R1, R2: 68 (0603); 0603-NO
R3: 1.5K (0603); 0603-NO
R4, R5: 470 (0603); 0603-NO
R6: 10K; 0805-NO
U$1, U$6: FIDUCIAL; FIDUCIAL_1MM
Y1: 16MHz; RESONATOR-SMD

Connections:
+5V: C8.1, D2.C, IC1.4 (VCC), IC1.6 (VCC), IC1.18 (AVCC), IC2.5 (VOUT), JP1.4, R3.2, R4.2, R6.2
A0: IC1.23 (PC0(ADC0)), JP4.7
A1: IC1.24 (PC1(ADC1)), JP4.8
A2: IC1.25 (PC2(ADC2)), JP4.9
A3: IC1.26 (PC3(ADC3)), JP4.10
A4: IC1.27 (PC4(ADC4/SDA)), JP4.11
A5: IC1.28 (PC5(ADC5/SCL)), JP4.12
A6: IC1.19 (ADC6), JP2.1
A7: IC1.22 (ADC7), JP2.2
AREF: C2.1, IC1.20 (AREF), JP4.6
D2: IC1.32 (PD2(INT0)), R2.2
D3: IC1.1 (PD3(INT1)), JP1.9
D4: IC1.2 (PD4(XCK/T0)), JP1.8
D5: IC1.9 (PD5(T1)), JP1.7
D6: IC1.10 (PD6(AIN0)), JP1.6
D7: IC1.11 (PD7(AIN1)), R1.2
D8: IC1.12 (PB0(ICP)), JP1.5
D9: IC1.13 (PB1(OC1A)), JP4.1
D10: IC1.14 (PB2(SS/OC1B)), JP4.2
D11: IC1.15 (PB3(MOSI/OC2)), JP4.3
D12: IC1.16 (PB4(MISO)), JP4.4
D13: IC1.17 (PB5(SCK)), JP4.5, R5.2
D+: CN1.D+, D1.C, R2.1
D-: CN1.D-, D4.C, R1.1, R3.1
DTR/RTS: C3.2, FTDI.6
GND: B1.C, BAT.1, C1.2, C2.2, C8.2, CN1.BASE@1 (GND), CN1.BASE@2 (GND), CN1.GND, CN1.SPRT@1 (GND), CN1.SPRT@2 (GND), CN1.SPRT@3 (GND), CN1.SPRT@4 (GND), D1.A, D4.A, FTDI.1, FTDI.2, IC1.3 (GND), IC1.5 (GND), IC1.21 (GND), IC1.TH (THERMAL), IC2.2 (GND), JP1.2, PWR.C, Q1.B (S), Q1.B' (S1), Y1.2
unnamed: B1.A, R5.1
unnamed: IC1.8 (PB7(XTAL2/TOSC2)), Y1.3
unnamed: IC1.7 (PB6(XTAL1/TOSC1)), Y1.1
unnamed: PWR.A, R4.1
RESET: C3.1, IC1.29 (PC6(/RESET)), JP1.12, Q1.A, Q1.A' (P1), R6.1
RXD: FTDI.4, IC1.30 (PD0(RXD)), JP1.11
TXD: FTDI.5, IC1.31 (PD1(TXD)), JP1.10
VBAT: BAT.2, C1.1, IC2.1 (VIN), IC2.3 (EN), JP1.1
VBUS: CN1.VBUS, D2.A, FTDI.3, JP1.3

Notes on the sheet:
Adafruit Pro Trinket 5V
http://adafruit.com/products/2000
CC 2.5 BY-SA

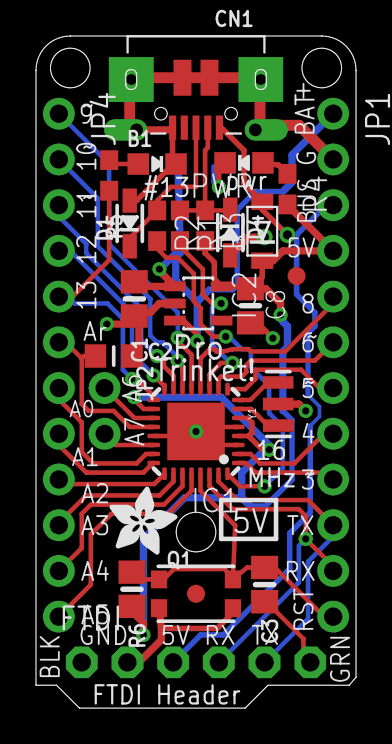
[picture p21: board Adafruit Pro Trinket 5v0.brd from above]

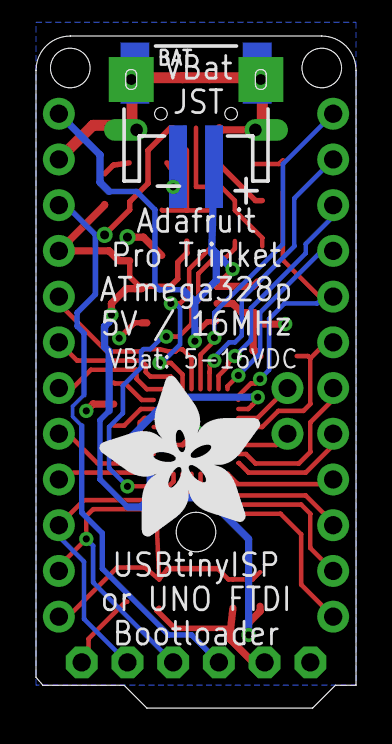
[picture p22: board Adafruit Pro Trinket 5v0.brd from below]

Board: 2 copper layers, 17.8 x 37.3 mm, 29 parts (2 on the bottom side), 35 nets.

Other parts of the board:
U$7: ADAFRUIT_3.5MM
U$9: ADAFRUIT_9MM
