shibbs/Light_node/(commit log)

2017-11-07 Initial commit!
    [Adafruit Pro Trinket 3v3.brd, Adafruit Pro Trinket 3v3.sch, Adafruit Pro Trinket 5v0.brd, Adafruit Pro Trinket 5v0.sch, Light_node.brd, Light_node.sch]
2017-11-07 Pulled the regulator components
    [Light_node.brd, Light_node.sch]
2017-11-10 added a bunch of new stuff in
    [Adafruit MicroLipo.brd, Adafruit MicroLipo.sch, Adafruit MicroUSB Lipo.brd, Adafruit MicroUSB Lipo.sch, Adafruit MiniLipo.brd, Adafruit MiniLipo.sch, Adafruit Pro Trinket 3v3.brd, Adafruit Pro Trinket 3v3.sch]
2017-11-10 jumpe us over to using the 3.3V version of the promicro
    [Light_node.brd, Light_node.sch]
2017-11-10 added in the accelerometer and removed the Reset pin
    [Adafruit LIS3DH.brd, Adafruit LIS3DH.sch, Light_node.brd, Light_node.sch]
2017-11-10 most of the layour is completed using standard LEDs, but we should move to neopixels on board
    [Adafruit NeoPixel 8 Stick v2.brd, Adafruit NeoPixel 8 Stick v2.sch, Adafruit NeoPixel 8 Stick.brd, Adafruit NeoPixel 8 Stick.sch, Light_node.brd, Light_node.sch]
2017-11-10 moved us to neopixels, added breakout headers, almost done
    [Light_node.brd, Light_node.sch]
2017-11-13 moced some parts around
    [Light_node.brd]
2017-11-14 Things are pretty close to complete
    [Light_node.brd, Light_node.sch]
2017-11-14 added the switch to the bottom
    [Light_node.brd, Light_node.sch]
2017-11-21 V1 Release!!
    [Light_node.brd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]
2017-12-17 got the boards running and initial code is working well!!!
    [Light_node.brd, Light_node.sch, light_node_BOM.xls, partlist.csv]
2017-12-19 Updated a lot of code. Got things working pretty well, but this actually relies on a library that sits in the arduino library folder
2018-02-03 Moved the Library folder and files into this level of the repo and then symlinked from the Arduino Libraries folder to make sure everyhing syncs and tracks better Updated the documentation accordingl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
2018-02-03 Cleaned up the power save function and may have fixed it. Cleaned up soem general code stuff as well, added masks instead of magic numbers for masking operations
    [LED_Strip_Functions.h, LN_strip_control.cpp, Strip_math.cpp, steve_stripper1.ino]
